emdraw/Pet-Keychain/hardware/case/llavero-cuerpo.stl

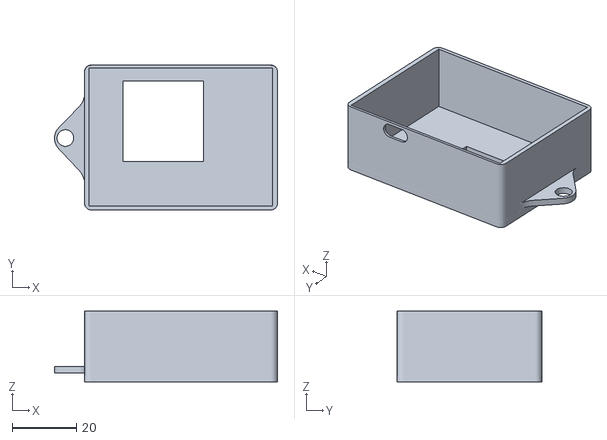
[picture p5: CAD file, 2026-10-08]
hardware/case/llavero-cuerpo.stl
69.4 x 45.0 x 22.0
