emdraw/Pet-Keychain/hardware/case/llavero.FCStd

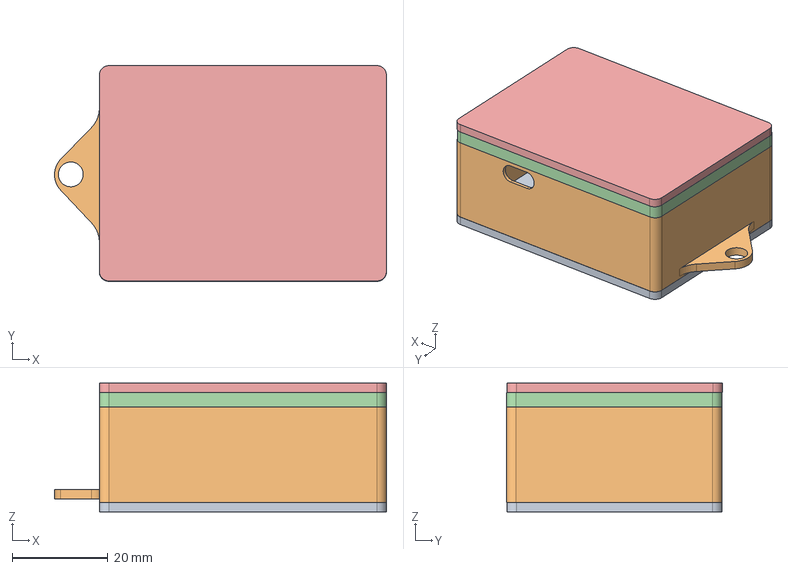
[picture p6: CAD file, 2026-10-08]
hardware/case/llavero.FCStd
69.4 x 45.1 x 26.9 mm
