emdraw/Pet-Keychain/hardware/case/llavero-tapa.stl

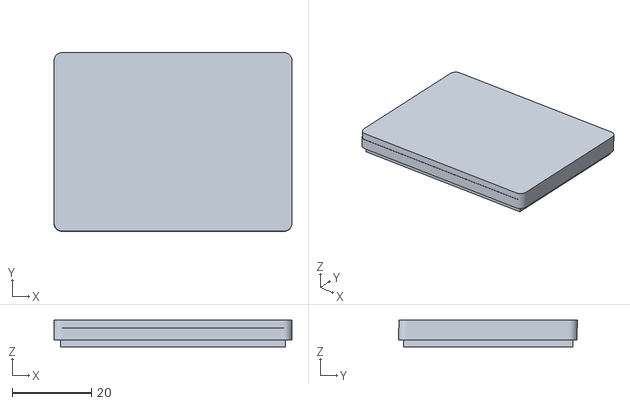
[picture p7: CAD file, 2026-10-08]
hardware/case/llavero-tapa.stl
60.0 x 45.1 x 6.79
