emdraw/Pet-Keychain/src/display.h

#pragma once
#define LGFX_USE_V1
#include <LovyanGFX.hpp>
#include "config.h"

class LGFX : public lgfx::LGFX_Device {
  lgfx::Panel_ST7789 _panel;
  lgfx::Bus_SPI _bus;

 public:
  LGFX() {
    {
      auto cfg = _bus.config();
      cfg.spi_host = SPI2_HOST;
      cfg.spi_mode = TFT_SPI_MODE;
      cfg.freq_write = 40000000;
      cfg.freq_read = 16000000;
      cfg.spi_3wire = true;
      cfg.use_lock = true;
      cfg.dma_channel = SPI_DMA_CH_AUTO;
      cfg.pin_sclk = PIN_TFT_SCK;
      cfg.pin_mosi = PIN_TFT_MOSI;
      cfg.pin_miso = -1;
      cfg.pin_dc = PIN_TFT_DC;
      _bus.config(cfg);
      _panel.setBus(&_bus);
    }
    {
      auto cfg = _panel.config();
      cfg.pin_cs = PIN_TFT_CS;
      cfg.pin_rst = PIN_TFT_RST;
      cfg.pin_busy = -1;
      cfg.panel_width = 240;
      cfg.panel_height = 240;
      cfg.memory_width = 240;
      cfg.memory_height = 320;
      cfg.offset_x = TFT_OFFSET_X;
      cfg.offset_y = TFT_OFFSET_Y;
      cfg.invert = TFT_INVERT;
      cfg.rgb_order = false;
      cfg.readable = false;
      cfg.bus_shared = false;
      _panel.config(cfg);
    }
    setPanel(&_panel);
  }
};
