emdraw/Pet-Keychain/(notices)

Notices in the files:
README.md:
License: MIT
